nospam2000/RASCSI/(list of files, drawings)

Other design files:
hw/rascsi_2p4/rascsi_2p4.dsn
