nospam2000/RASCSI/hw/rascsi_2p4/rascsi_2p4.kicad_pcb

## KiCad design hw/rascsi_2p4/rascsi_2p4.kicad_pcb (2021-12-07)

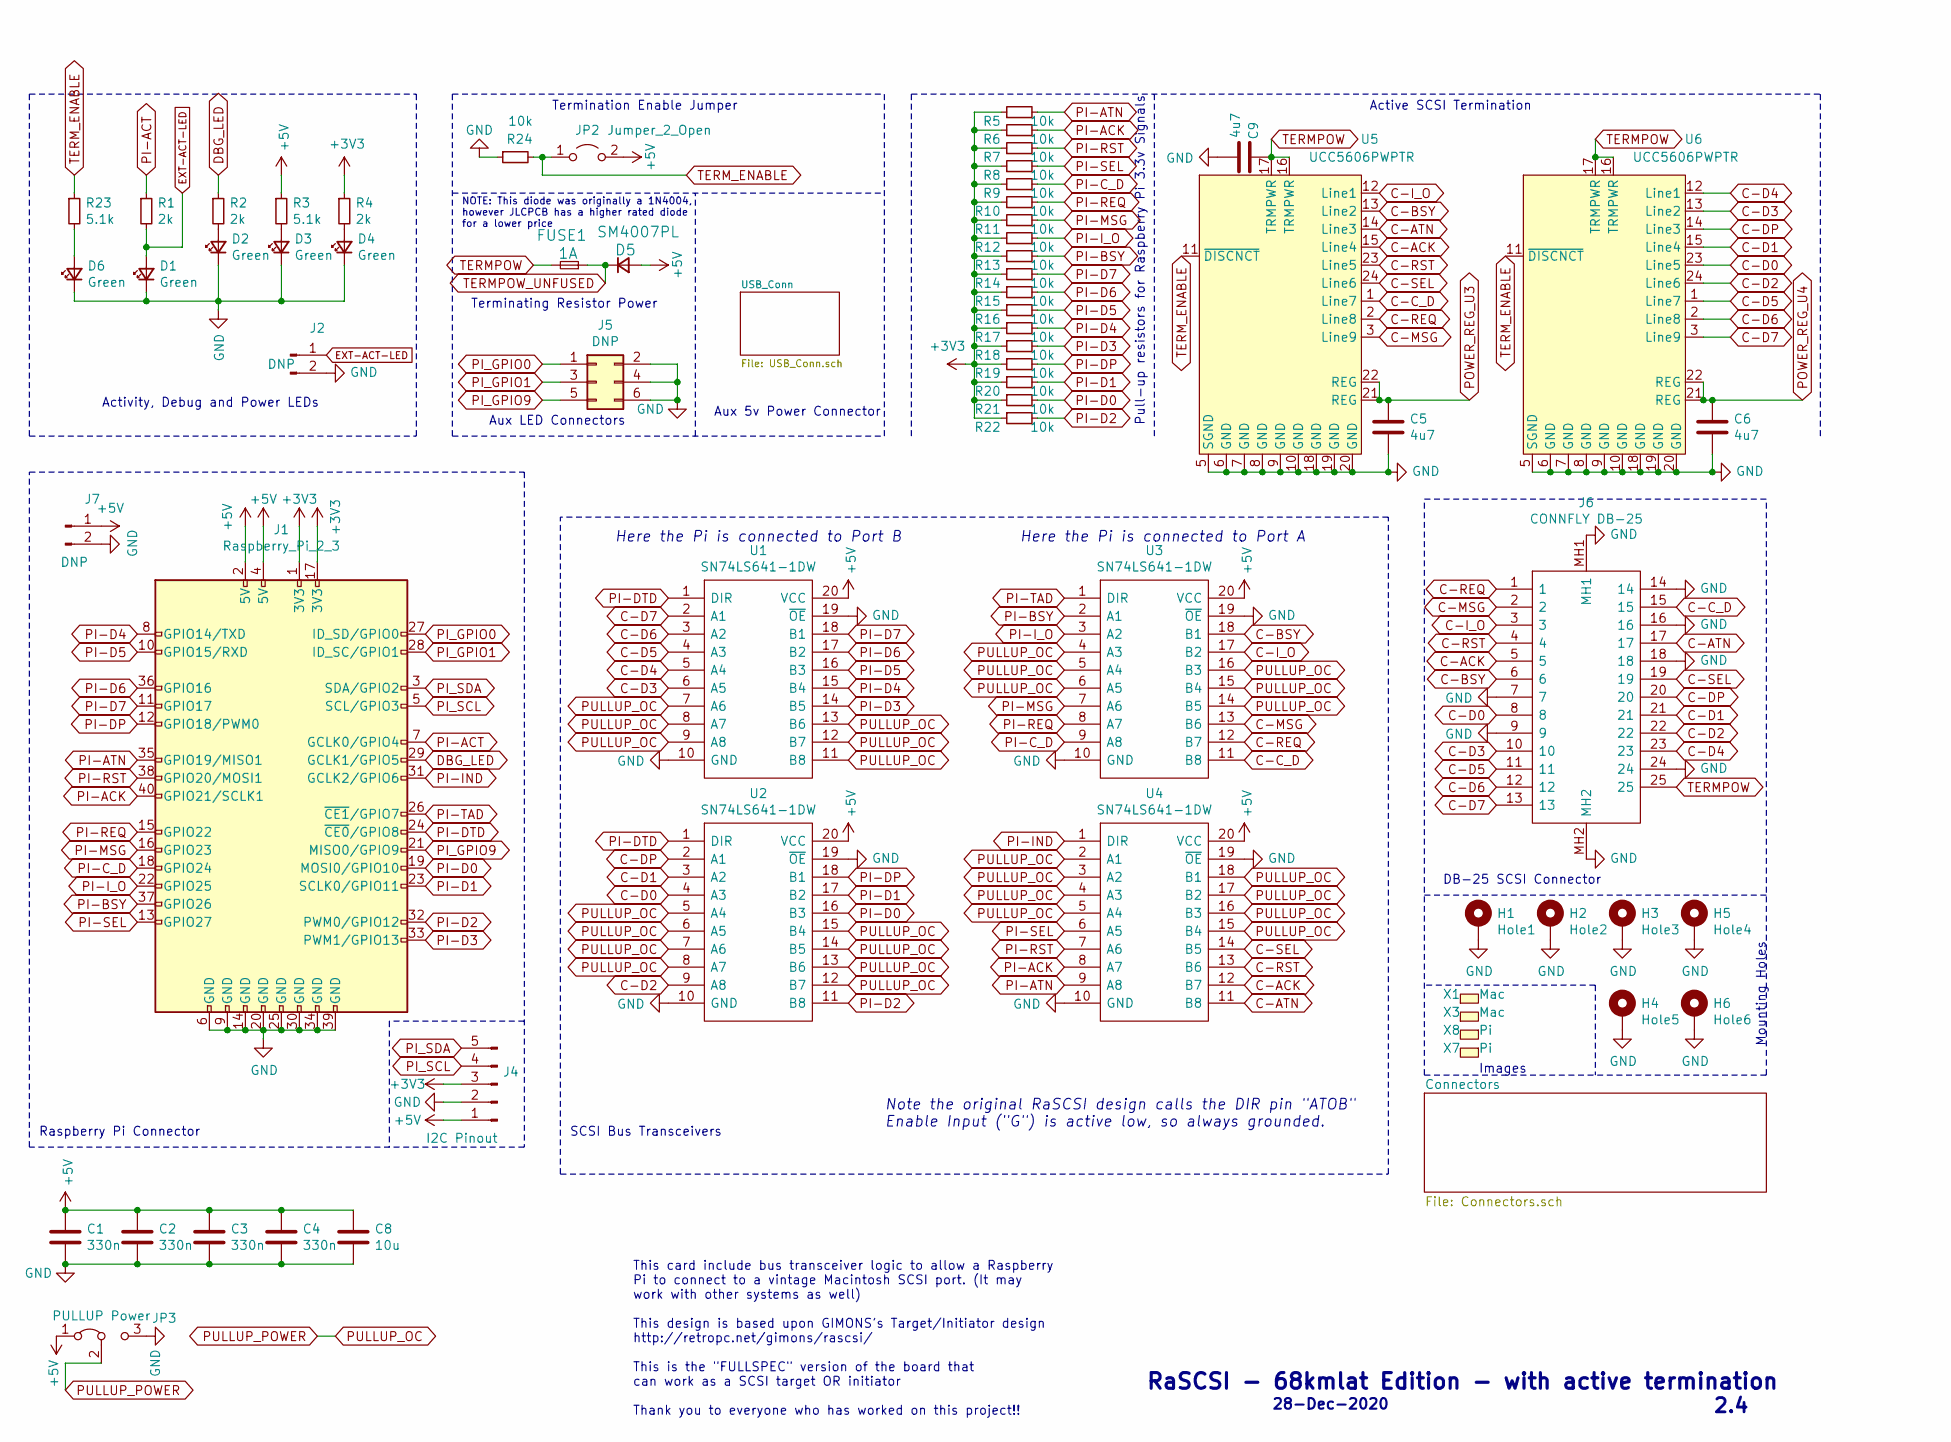
[picture p1: schematic rascsi_2p4.sch]

Parts:
C1, C2, C3, C4: 330n; C_0805_2012Metric; Manufacturer_Part_Number 0805B334K500NT; LCSC C1740
C5, C6, C9: 4u7; C_0805_2012Metric; Manufacturer_Part_Number CL21A475KAQNNNE; LCSC C1779
C8: 10u; C_0805_2012Metric; Manufacturer_Part_Number CL21A106KAYNNNE; LCSC C15850
D1, D2, D3, D4, D6: Green; LED_0805_2012Metric; Manufacturer_Part_Number C2297; LCSC C2297
D5: SM4007PL; D_SOD-123F; Manufacturer_Part_Number SM4007PL; LCSC C64898
FUSE1: 1A; Fuse_1206_3216Metric; Manufacturer_Part_Number 12B1100B; LCSC C182974
H1: Hole1; MountingHole_2.7mm_M2.5_Pad_Via; Manufacturer_Part_Number DNP; LCSC DNP
H2: Hole2; MountingHole_2.7mm_M2.5_Pad_Via; Manufacturer_Part_Number DNP; LCSC DNP
H3: Hole3; MountingHole_2.7mm_M2.5_Pad_Via; Manufacturer_Part_Number DNP; LCSC DNP
H4: Hole5; MountingHole_2.7mm_M2.5_Pad_Via; Manufacturer_Part_Number DNP; LCSC DNP
H5: Hole4; MountingHole_2.7mm_M2.5_Pad_Via; Manufacturer_Part_Number DNP; LCSC DNP
H6: Hole6; MountingHole_2.7mm_M2.5_Pad_Via; Manufacturer_Part_Number DNP; LCSC DNP
J1: Raspberry_Pi_2_3; PinSocket_2x20_P2.54mm_Vertical; Manufacturer_Part_Number C50982; LCSC C50982
J2: DNP; PinHeader_1x02_P2.54mm_Horizontal; Manufacturer_Part_Number DNP; LCSC DNP
J4: I2C Pinout; PinSocket_1x05_P2.54mm_Vertical; Manufacturer_Part_Number C50950; LCSC C50950
J5: DNP; PinHeader_2x03_P2.54mm_Vertical; Manufacturer_Part_Number DNP; LCSC DNP
J6: CONNFLY DB-25; L717SDB25PA4CH4F_JLCPCB_hand_mount; Manufacturer_Part_Number DS1037-25FNAKT74-0CC; LCSC C77838
J7: DNP; PinHeader_1x02_P2.54mm_Vertical; Manufacturer_Part_Number DNP; LCSC DNP
JP2: Jumper_2_Open; PinHeader_1x02_P2.54mm_Horizontal
JP3: PULLUP Power; SolderJumper-3_P1.3mm_Bridged12_RoundedPad1.0x1.5mm; Manufacturer_Part_Number DNP; LCSC DNP
R1, R2, R4: 2k; R_0402_1005Metric; Manufacturer_Part_Number 0402WGF2001TCE; LCSC C4109
R3, R23: 5.1k; R_0402_1005Metric; Manufacturer_Part_Number 0402WGF5101TCE; LCSC C25905
R5, R6, R7, R8, R9, R10, R11, R12, R13, R14, R15, R16, R17, R18, R19, R20, R21, R22, R24: 10k; R_0402_1005Metric; Manufacturer_Part_Number 0402WGF1002TCE; LCSC C25744
U1, U2, U3, U4: SN74LS641-1DW; SOIC-20W_7.5x12.8mm_P1.27mm; Mouser Part Number 595-SN74LS641-1DW
U5, U6: UCC5606PWPTR; TSSOP-24_6.1x7.8mm_P0.65mm; LCSC C2649373
X1, X3: Mac; mac_happy_small; Manufacturer_Part_Number N/A; LCSC N/A
X7: Pi; pi_logo; Manufacturer_Part_Number N/A; LCSC N/A
X8: Pi; scsi_logo; Manufacturer_Part_Number N/A; LCSC N/A

Connections:
+3V3: J1.1 (3V3), J1.17 (3V3), J4.3, R4.1, R5.1, R6.1, R7.1, R8.1, R9.1, R10.1, R11.1, R12.1, R13.1, R14.1, R15.1, R16.1, R17.1, R18.1, R19.1, R20.1, R21.1, R22.1
+5V: C1.1, C2.1, C3.1, C4.1, C8.1, D5.2 (A), J1.2 (5V), J1.4 (5V), J4.1, J7.1, JP2.2 (B), JP3.1 (A), R3.1, U1.20 (VCC), U2.20 (VCC), U3.20 (VCC), U4.20 (VCC); also elsewhere on the board
C-ACK: J6.5, U4.12 (B7), U5.15 (Line4); also elsewhere on the board
C-ATN: J6.17, U4.11 (B8), U5.14 (Line3); also elsewhere on the board
C-BSY: J6.6, U3.18 (B1), U5.13 (Line2); also elsewhere on the board
C-C_D: J6.15, U3.11 (B8), U5.1 (Line7); also elsewhere on the board
C-D0: J6.8, U2.4 (A3), U6.23 (Line5); also elsewhere on the board
C-D1: J6.21, U2.3 (A2), U6.15 (Line4); also elsewhere on the board
C-D2: J6.22, U2.9 (A8), U6.24 (Line6); also elsewhere on the board
C-D3: J6.10, U1.6 (A5), U6.13 (Line2); also elsewhere on the board
C-D4: J6.23, U1.5 (A4), U6.12 (Line1); also elsewhere on the board
C-D5: J6.11, U1.4 (A3), U6.1 (Line7); also elsewhere on the board
C-D6: J6.12, U1.3 (A2), U6.2 (Line8); also elsewhere on the board
C-D7: J6.13, U1.2 (A1), U6.3 (Line9); also elsewhere on the board
C-DP: J6.20, U2.2 (A1), U6.14 (Line3); also elsewhere on the board
C-I_O: J6.3, U3.17 (B2), U5.12 (Line1); also elsewhere on the board
C-MSG: J6.2, U3.13 (B6), U5.3 (Line9); also elsewhere on the board
C-REQ: J6.1, U3.12 (B7), U5.2 (Line8); also elsewhere on the board
C-RST: J6.4, U4.13 (B6), U5.23 (Line5); also elsewhere on the board
C-SEL: J6.19, U4.14 (B5), U5.24 (Line6); also elsewhere on the board
DBG_LED: J1.29 (GCLK1/GPIO5), R2.1
EXT-ACT-LED: D1.2 (A), J2.1, R1.2; also elsewhere on the board
GND: C1.2, C2.2, C3.2, C4.2, C5.2, C6.2, C8.2, C9.2, D1.1 (K), D2.1 (K), D3.1 (K), D4.1 (K), D6.1 (K), H1.1, H2.1, H3.1, H4.1, H5.1, H6.1, J1.6 (GND), J1.9 (GND), J1.14 (GND), J1.20 (GND), J1.25 (GND), J1.30 (GND), J1.34 (GND), J1.39 (GND), J2.2, J4.2, J5.2, J5.4, J5.6, J6.7, J6.9, J6.14, J6.16, J6.18, J6.24, J6.MH1, J6.MH2, J7.2, JP3.3 (B), R24.1, U1.10 (GND), U1.19 (~OE), U2.10 (GND), U2.19 (~OE), U3.10 (GND), U3.19 (~OE), U4.10 (GND), U4.19 (~OE), U5.5 (SGND), U5.6 (GND), U5.7 (GND), U5.8 (GND), U5.9 (GND), U5.10 (GND), U5.18 (GND), U5.19 (GND), U5.20 (GND), U6.5 (SGND), U6.6 (GND), U6.7 (GND), U6.8 (GND), U6.9 (GND), U6.10 (GND), U6.18 (GND), U6.19 (GND), U6.20 (GND); also elsewhere on the board
unnamed: D2.2 (A), R2.2
unnamed: D3.2 (A), R3.2
unnamed: D4.2 (A), R4.2
unnamed: D6.2 (A), R23.2
PI-ACK: J1.40 (GPIO21/SCLK1), R6.2, U4.8 (A7)
PI-ACT: J1.7 (GCLK0/GPIO4), R1.1
PI-ATN: J1.35 (GPIO19/MISO1), R5.2, U4.9 (A8)
PI-BSY: J1.37 (GPIO26), R13.2, U3.2 (A1)
PI-C_D: J1.18 (GPIO24), R9.2, U3.9 (A8)
PI-D0: J1.19 (MOSI0/GPIO10), R21.2, U2.16 (B3)
PI-D1: J1.23 (SCLK0/GPIO11), R20.2, U2.17 (B2)
PI-D2: J1.32 (PWM0/GPIO12), R22.2, U2.11 (B8)
PI-D3: J1.33 (PWM1/GPIO13), R18.2, U1.14 (B5)
PI-D4: J1.8 (GPIO14/TXD), R17.2, U1.15 (B4)
PI-D5: J1.10 (GPIO15/RXD), R16.2, U1.16 (B3)
PI-D6: J1.36 (GPIO16), R15.2, U1.17 (B2)
PI-D7: J1.11 (GPIO17), R14.2, U1.18 (B1)
PI-DP: J1.12 (GPIO18/PWM0), R19.2, U2.18 (B1)
PI-DTD: J1.24 (~CE0~/GPIO8), U1.1 (DIR), U2.1 (DIR)
PI-IND: J1.31 (GCLK2/GPIO6), U4.1 (DIR)
PI-I_O: J1.22 (GPIO25), R12.2, U3.3 (A2)
PI-MSG: J1.16 (GPIO23), R11.2, U3.7 (A6)
PI-REQ: J1.15 (GPIO22), R10.2, U3.8 (A7)
PI-RST: J1.38 (GPIO20/MOSI1), R7.2, U4.7 (A6)
PI-SEL: J1.13 (GPIO27), R8.2, U4.6 (A5)
PI-TAD: J1.26 (~CE1~/GPIO7), U3.1 (DIR)
PI_GPIO0: J1.27 (ID_SD/GPIO0), J5.1
PI_GPIO1: J1.28 (ID_SC/GPIO1), J5.3
PI_GPIO9: J1.21 (MISO0/GPIO9), J5.5
PI_SCL: J1.5 (SCL/GPIO3), J4.4
PI_SDA: J1.3 (SDA/GPIO2), J4.5
POWER_REG_U3: C5.1, U5.21 (REG), U5.22 (REG)
POWER_REG_U4: C6.1, U6.21 (REG), U6.22 (REG)
PULLUP_OC: JP3.2 (C), U1.7 (A6), U1.8 (A7), U1.9 (A8), U1.11 (B8), U1.12 (B7), U1.13 (B6), U2.5 (A4), U2.6 (A5), U2.7 (A6), U2.8 (A7), U2.12 (B7), U2.13 (B6), U2.14 (B5), U2.15 (B4), U3.4 (A3), U3.5 (A4), U3.6 (A5), U3.14 (B5), U3.15 (B4), U3.16 (B3), U4.2 (A1), U4.3 (A2), U4.4 (A3), U4.5 (A4), U4.15 (B4), U4.16 (B3), U4.17 (B2), U4.18 (B1)
TERMPOW: C9.1, FUSE1.2, J6.25, U5.16 (TRMPWR), U5.17 (TRMPWR), U6.16 (TRMPWR), U6.17 (TRMPWR); also elsewhere on the board
TERMPOW_UNFUSED: D5.1 (K), FUSE1.1
TERM_ENABLE: JP2.1 (A), R23.1, R24.2, U5.11 (~DISCNCT), U6.11 (~DISCNCT)

Notes on the sheet:
Note the original RaSCSI design calls the DIR pin "ATOB" Enable Input ("G") is active low, so always grounded.
Activity, Debug and Power LEDs
Pull-up resistors for Raspberry Pi 3.3v Signals
Raspberry Pi Connector
Terminating Resistor Power
SCSI Bus Transceivers
DB-25 SCSI Connector
This card include bus transceiver logic to allow a Raspberry Pi to connect to a vintage Macintosh SCSI port. (It may work with other systems as well) This design is based upon GIMONS's Target/Initiator design http://retropc.net/gimons/rascsi/ This is the "FULLSPEC" version of the board that can wor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
Images
Mounting Holes
RaSCSI - 68kmlat Edition - with active termination
2.4
28-Dec-2020
Aux LED Connectors
Aux 5v Power Connector
NOTE: This diode was originally a 1N4004, however JLCPCB has a higher rated diode for a lower price
Active SCSI Termination
Termination Enable Jumper
Here the Pi is connected to Port A
Here the Pi is connected to Port B

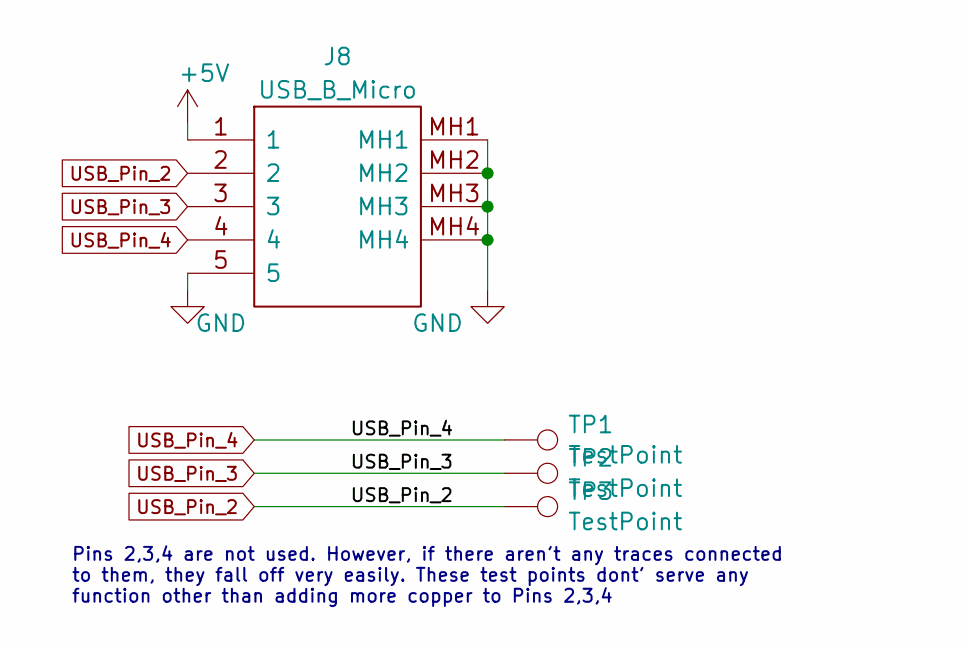
[picture p2: schematic USB_Conn.sch]

Parts:
J8: USB_B_Micro; U254051N4BH806_JLCPCB_hand_mount; Manufacturer_Part_Number U254-051N-4BH806; LCSC C319170
TP1, TP2, TP3: TestPoint; TestPoint_Pad_D1.0mm; Manufacturer_Part_Number N/A; LCSC N/A

Connections:
+5V: J8.1; also elsewhere on the board
GND: J8.5, J8.MH1, J8.MH2, J8.MH3, J8.MH4; also elsewhere on the board
USB_Pin_2: J8.2, TP3.1
USB_Pin_3: J8.3, TP2.1
USB_Pin_4: J8.4, TP1.1

Notes on the sheet:
Pins 2,3,4 are not used. However, if there aren't any traces connected to them, they fall off very easily. These test points dont' serve any function other than adding more copper to Pins 2,3,4

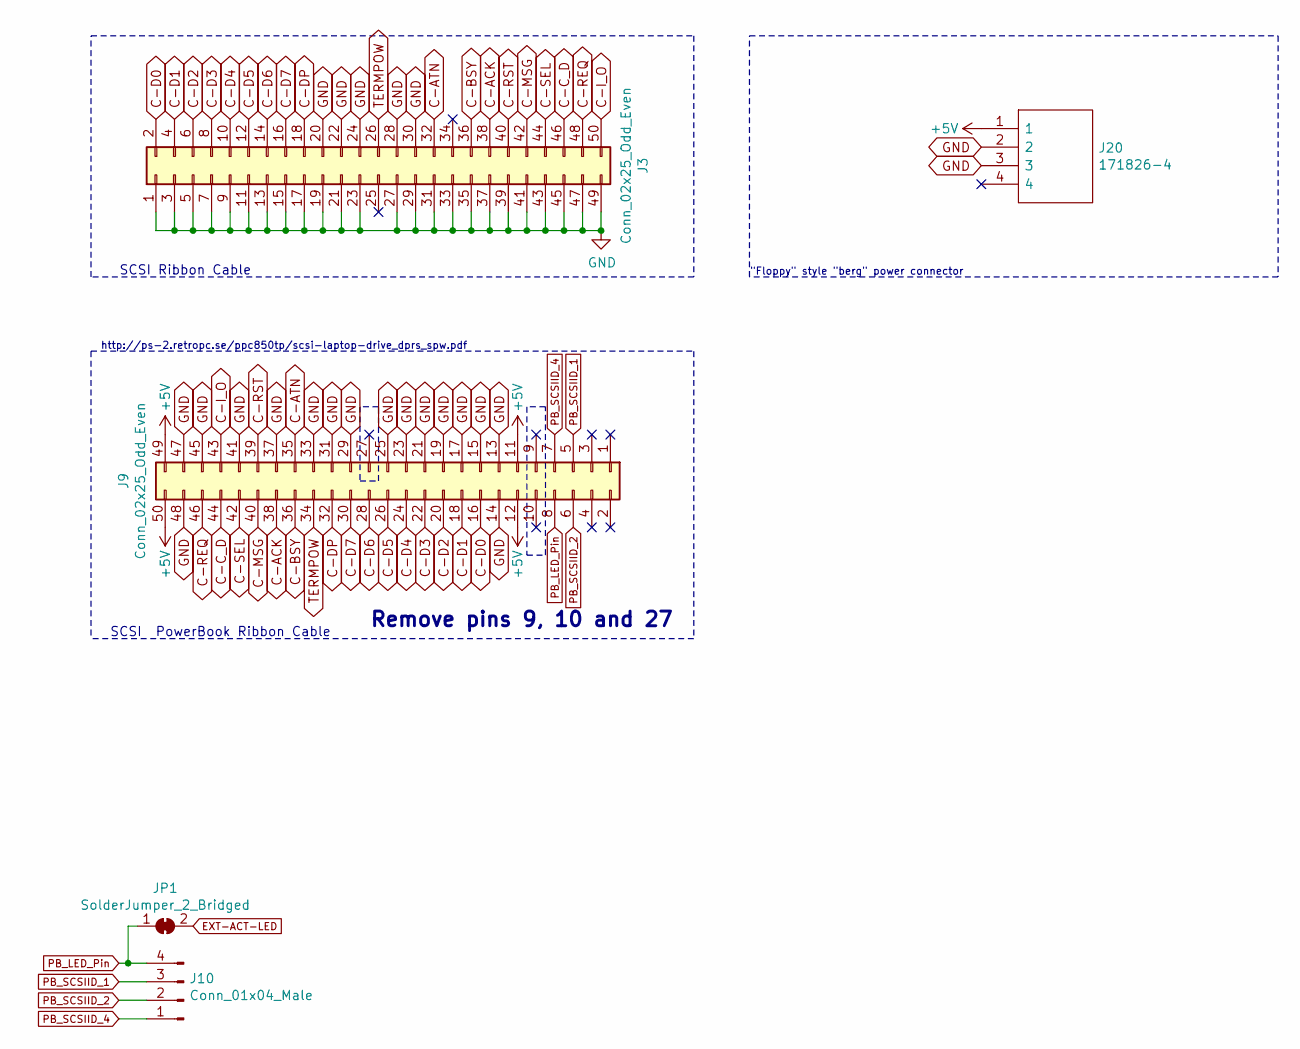
[picture p3: schematic Connectors.sch]

Parts:
J3: Conn_02x25_Odd_Even; PinHeader_2x25_P2.54mm_Vertical; Manufacturer_Part_Number C30006; LCSC C30006
J9: Conn_02x25_Odd_Even; PinHeader_2x25_P2.00mm_Horizontal; Manufacturer_Part_Number C3407; LCSC C3407
J10: Conn_01x04_Male; PinHeader_1x04_P2.00mm_Vertical
J20: 171826-4; SHDRRA4W69P0X250_1X4_1000X1350X670P; Mouser Part Number 571-1718264
JP1: SolderJumper_2_Bridged; SolderJumper-2_P1.3mm_Bridged_Pad1.0x1.5mm

Connections:
+5V: J9.11, J9.12, J9.49, J9.50, J20.1; also elsewhere on the board
C-ACK: J3.38, J9.38; also elsewhere on the board
C-ATN: J3.32, J9.35; also elsewhere on the board
C-BSY: J3.36, J9.36; also elsewhere on the board
C-C_D: J3.46, J9.44; also elsewhere on the board
C-D0: J3.2, J9.16; also elsewhere on the board
C-D1: J3.4, J9.18; also elsewhere on the board
C-D2: J3.6, J9.20; also elsewhere on the board
C-D3: J3.8, J9.22; also elsewhere on the board
C-D4: J3.10, J9.24; also elsewhere on the board
C-D5: J3.12, J9.26; also elsewhere on the board
C-D6: J3.14, J9.28; also elsewhere on the board
C-D7: J3.16, J9.30; also elsewhere on the board
C-DP: J3.18, J9.32; also elsewhere on the board
C-I_O: J3.50, J9.43; also elsewhere on the board
C-MSG: J3.42, J9.40; also elsewhere on the board
C-REQ: J3.48, J9.46; also elsewhere on the board
C-RST: J3.40, J9.39; also elsewhere on the board
C-SEL: J3.44, J9.42; also elsewhere on the board
EXT-ACT-LED: JP1.2 (B); also elsewhere on the board
GND: J3.1, J3.3, J3.5, J3.7, J3.9, J3.11, J3.13, J3.15, J3.17, J3.19, J3.20, J3.21, J3.22, J3.23, J3.24, J3.27, J3.28, J3.29, J3.30, J3.31, J3.33, J3.35, J3.37, J3.39, J3.41, J3.43, J3.45, J3.47, J3.49, J9.13, J9.14, J9.15, J9.17, J9.19, J9.21, J9.23, J9.25, J9.29, J9.31, J9.33, J9.37, J9.41, J9.45, J9.47, J9.48, J20.2, J20.3; also elsewhere on the board
PB_LED_Pin: J9.8, J10.4, JP1.1 (A)
PB_SCSIID_1: J9.5, J10.3
PB_SCSIID_2: J9.6, J10.2
PB_SCSIID_4: J9.7, J10.1
TERMPOW: J3.26, J9.34; also elsewhere on the board

Notes on the sheet:
SCSI Ribbon Cable
SCSI PowerBook Ribbon Cable
http://ps-2.retropc.se/ppc850tp/scsi-laptop-drive_dprs_spw.pdf
Remove pins 9, 10 and 27
"Floppy" style "berg" power connector

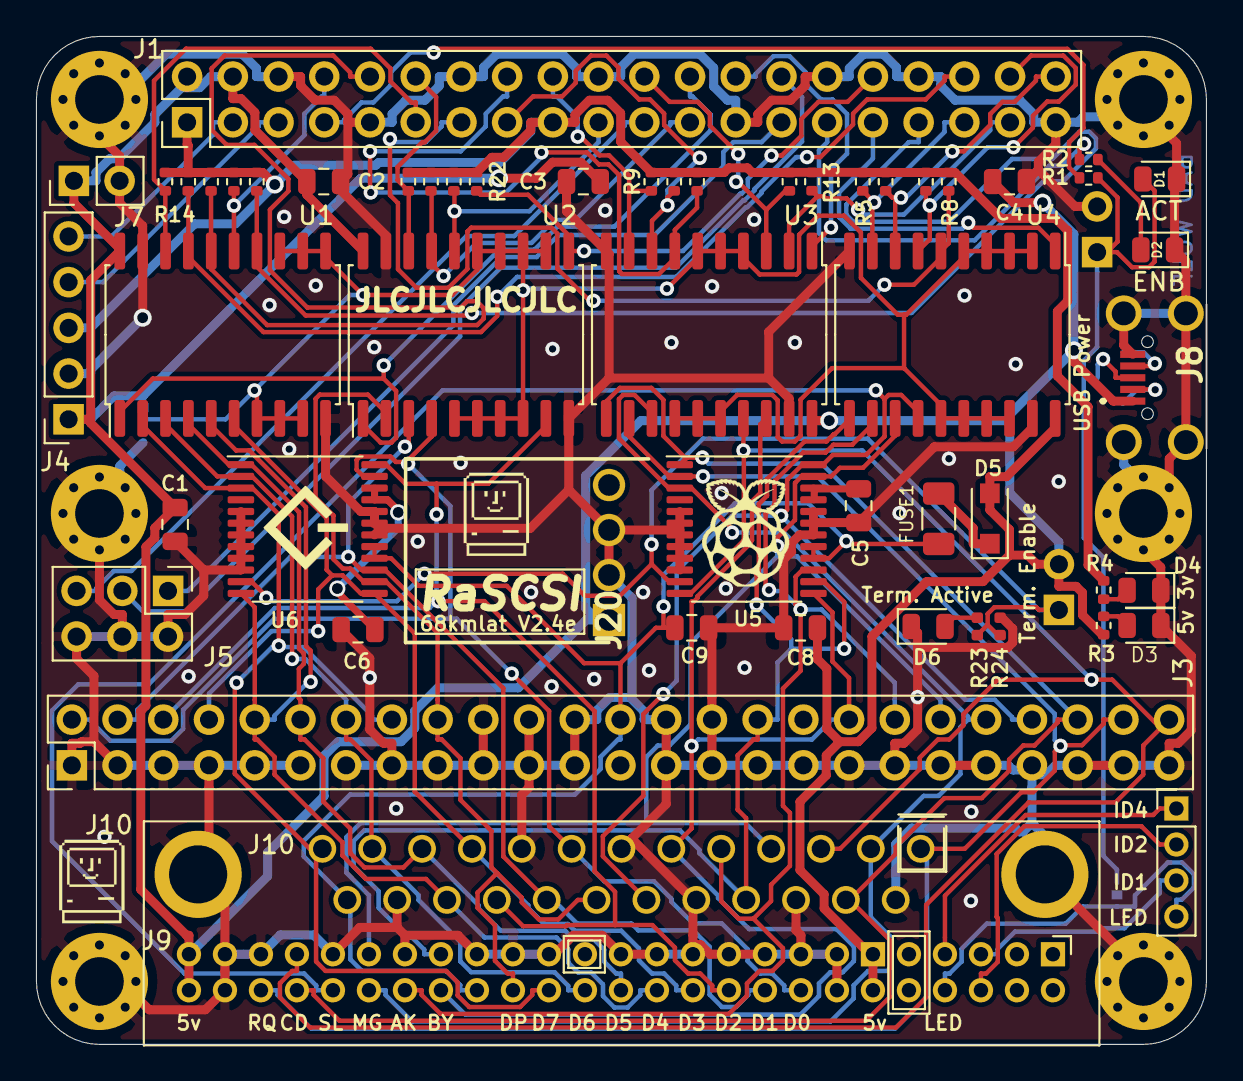
[picture p4: board rascsi_2p4.kicad_pcb from above]

Board: 2 copper layers, 65.0 x 56.0 mm, 72 parts (0 on the bottom side), 67 nets.
