nospam2000/RASCSI/(commit log)

2021-08-10 replaced 4x74LS641 by 2x74ALVC164245DGG added pulldowns for floating in/out pins (instead of directly wiring them to ground) setup for autorouting
    [rascsi_2p4.dsn, rascsi_2p4.kicad_pcb, rascsi_2p4.sch, rascsi_2p4_BOM.csv]
2021-08-10 added intermediate routing results with 136 vias
    [rascsi_2p4.dsn, rascsi_2p4.kicad_pcb]
2021-08-10 imported routed traces; fixed orientation of U1 and U2
    [rascsi_2p4-B_Mask.gbr, rascsi_2p4-B_SilkS.gbr, rascsi_2p4-Bottom.gbr, rascsi_2p4-Edge_Cuts.gbr, rascsi_2p4-F_Mask.gbr, rascsi_2p4-F_SilkS.gbr, rascsi_2p4-NPTH.drl, rascsi_2p4-PTH.drl]
2021-08-10 added U1/U2 caps for 3.3V
    [rascsi_2p4.kicad_pcb, rascsi_2p4.sch, rascsi_2p4_BOM.csv]
2021-08-11 replaced R59-R86 by 100k to reduce power dissipation
    [rascsi_2p4.kicad_pcb, rascsi_2p4.sch, rascsi_2p4_BOM.csv]
2021-08-11 fixed some silkscreen texts removed 2nd JLC... mark fixed overlapping termpower text fixed version on backside
    [rascsi_2p4.kicad_pcb]
2021-08-11 imported spectra routing data with 111 vias
    [rascsi_2p4-B_Mask.gbr, rascsi_2p4-B_SilkS.gbr, rascsi_2p4-Bottom.gbr, rascsi_2p4-Edge_Cuts.gbr, rascsi_2p4-F_Mask.gbr, rascsi_2p4-F_SilkS.gbr, rascsi_2p4-NPTH.drl, rascsi_2p4-PTH.drl]
2021-08-11 fixed rotation of S1
    [rascsi_2p4-top-pos_fixed.csv]
2021-08-11 use active SCSI termination
    [rascsi_2p4-top-pos_fixed_reduced.csv, rascsi_2p4.dsn, rascsi_2p4.kicad_pcb, rascsi_2p4.sch, rascsi_2p4_BOM.csv]
2021-08-11 moved C7 and fixed some silkscreen text positions
    [rascsi_2p4.kicad_pcb]
2021-08-11 moved C9 and C8 for successful routing
    [rascsi_2p4.dsn, rascsi_2p4.kicad_pcb, rascsi_2p4.sch]
2021-08-12 added NarrowPowerAdapter to easy routing
    [rascsi_2p4.kicad_pcb, rascsi_2p4.sch, rascsi_2p4_BOM.csv]
2021-08-12 imported routing result with 96 vias
    [rascsi_2p4-B_Mask.gbr, rascsi_2p4-B_SilkS.gbr, rascsi_2p4-Bottom.gbr, rascsi_2p4-Edge_Cuts.gbr, rascsi_2p4-F_Mask.gbr, rascsi_2p4-F_SilkS.gbr, rascsi_2p4-NPTH.drl, rascsi_2p4-PTH.drl]
2021-08-12 first routable version
    [rascsi_2p4.dsn, rascsi_2p4.kicad_pcb, rascsi_2p4.sch]
2021-08-13 routed with 99 vias but not imported
    [rascsi_2p4.dsn, rascsi_2p4.kicad_pcb, rascsi_2p4_BOM.csv]
2021-08-13 moved components to make space for 50 pin conn
    [rascsi_2p4.dsn, rascsi_2p4.kicad_pcb, rascsi_2p4.sch, rascsi_2p4_BOM.csv]
2021-08-14 optimized routing (81 vias)
    [rascsi_2p4-B_Mask.gbr, rascsi_2p4-B_SilkS.gbr, rascsi_2p4-Bottom.gbr, rascsi_2p4-Edge_Cuts.gbr, rascsi_2p4-F_Mask.gbr, rascsi_2p4-F_SilkS.gbr, rascsi_2p4-NPTH.drl, rascsi_2p4-PTH.drl]
2021-08-14 added jlcpcb part number of scsi terminator
    [rascsi_2p4.sch, rascsi_2p4_BOM.csv]
2021-08-14 changed sild label "Term." by "Termination"
    [rascsi_2p4-B_Mask.gbr, rascsi_2p4-B_SilkS.gbr, rascsi_2p4-Bottom.gbr, rascsi_2p4-Edge_Cuts.gbr, rascsi_2p4-F_Mask.gbr, rascsi_2p4-F_SilkS.gbr, rascsi_2p4-NPTH.drl, rascsi_2p4-PTH.drl]
2021-08-14 set BOM fields to DNP
    [rascsi_2p4.sch, rascsi_2p4_BOM.csv]
2021-08-14 swapped R18 and R22 slightly moved R14 to R18
    [rascsi_2p4.dsn, rascsi_2p4.kicad_pcb, rascsi_2p4.sch]
2021-08-14 newly routed with 71 vias
    [rascsi_2p4-B_Mask.gbr, rascsi_2p4-B_SilkS.gbr, rascsi_2p4-Bottom.gbr, rascsi_2p4-Edge_Cuts.gbr, rascsi_2p4-F_Mask.gbr, rascsi_2p4-F_SilkS.gbr, rascsi_2p4-NPTH.drl, rascsi_2p4-PTH.drl]
2021-08-15 added more GND for cooling term ICs
    [rascsi_2p4-B_Mask.gbr, rascsi_2p4-B_SilkS.gbr, rascsi_2p4-Bottom.gbr, rascsi_2p4-Edge_Cuts.gbr, rascsi_2p4-F_Mask.gbr, rascsi_2p4-F_SilkS.gbr, rascsi_2p4-NPTH.drl, rascsi_2p4-PTH.drl]
2021-08-16 made 25pin and USB conn placeable by JLCPCB
    [Connectors.sch, USB_Conn.sch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]
2021-12-04 fixed logo position changed origin settings and gerber/pos export setting
    [rascsi_2p4.kicad_pcb]
2021-12-05 fixed part positioning at JLCPCB by removing 2x25 Pin Header from Handmount
    [Connectors.sch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]
2021-12-05 added hand soldering footprint for 2x25 conn to internal lib
2021-12-05 changed /TERM_ENABLE to TERM_ENABLE so that a plugged jumper enables termination
    [rascsi_2p4-B_Mask.gbr, rascsi_2p4-B_SilkS.gbr, rascsi_2p4-Bottom.gbr, rascsi_2p4-Edge_Cuts.gbr, rascsi_2p4-F_Mask.gbr, rascsi_2p4-F_SilkS.gbr, rascsi_2p4-NPTH.drl, rascsi_2p4-PTH.drl]
2021-12-05 added solder paste layers
    [rascsi_2p4-B_Paste.gbr, rascsi_2p4-F_Paste.gbr]
2021-12-05 fixed position of R23 and R24 silk
    [rascsi_2p4-B_Mask.gbr, rascsi_2p4-B_Paste.gbr, rascsi_2p4-B_SilkS.gbr, rascsi_2p4-Bottom.gbr, rascsi_2p4-Edge_Cuts.gbr, rascsi_2p4-F_Mask.gbr, rascsi_2p4-F_Paste.gbr, rascsi_2p4-F_SilkS.gbr]
2021-12-05 increased ground fill
    [rascsi_2p4-B_Mask.gbr, rascsi_2p4-B_Paste.gbr, rascsi_2p4-B_SilkS.gbr, rascsi_2p4-Bottom.gbr, rascsi_2p4-Edge_Cuts.gbr, rascsi_2p4-F_Mask.gbr, rascsi_2p4-F_Paste.gbr, rascsi_2p4-F_SilkS.gbr]
2021-12-07 fixed wiring of U3 and U4 fixed priority of term enable
    [rascsi_2p4.dsn, rascsi_2p4.kicad_pcb, rascsi_2p4.sch]
2021-12-07 imported routing result, added extra GND fill and vias
    [rascsi_2p4-B_Mask.gbr, rascsi_2p4-B_Paste.gbr, rascsi_2p4-B_SilkS.gbr, rascsi_2p4-Bottom.gbr, rascsi_2p4-Edge_Cuts.gbr, rascsi_2p4-F_Mask.gbr, rascsi_2p4-F_Paste.gbr, rascsi_2p4-F_SilkS.gbr]
